AgitPOV/AgitPOV_WiFi/Stuff/AgitPOV_WiFi_1.jpg

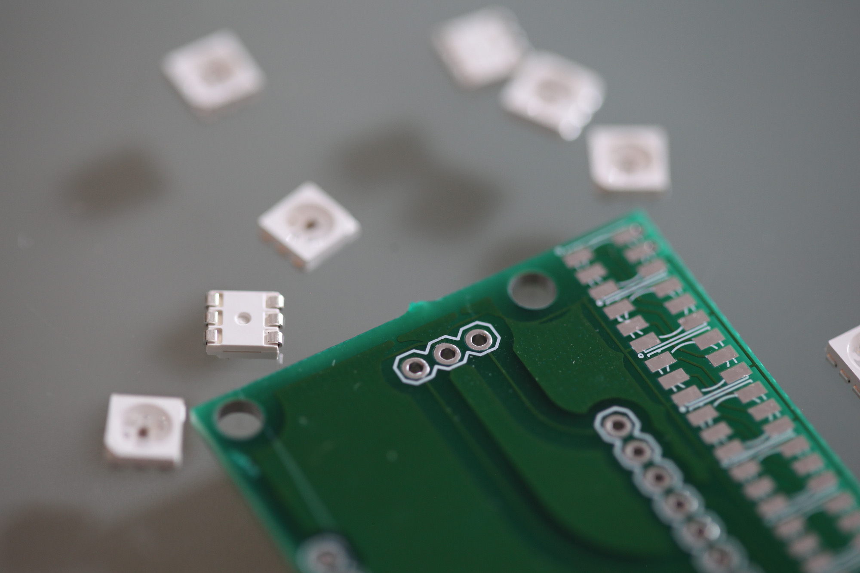
Stuff/AgitPOV_WiFi_1.jpg
