AgitPOV/AgitPOV_WiFi/Stuff/AgitPOV_WiFi_2.jpg

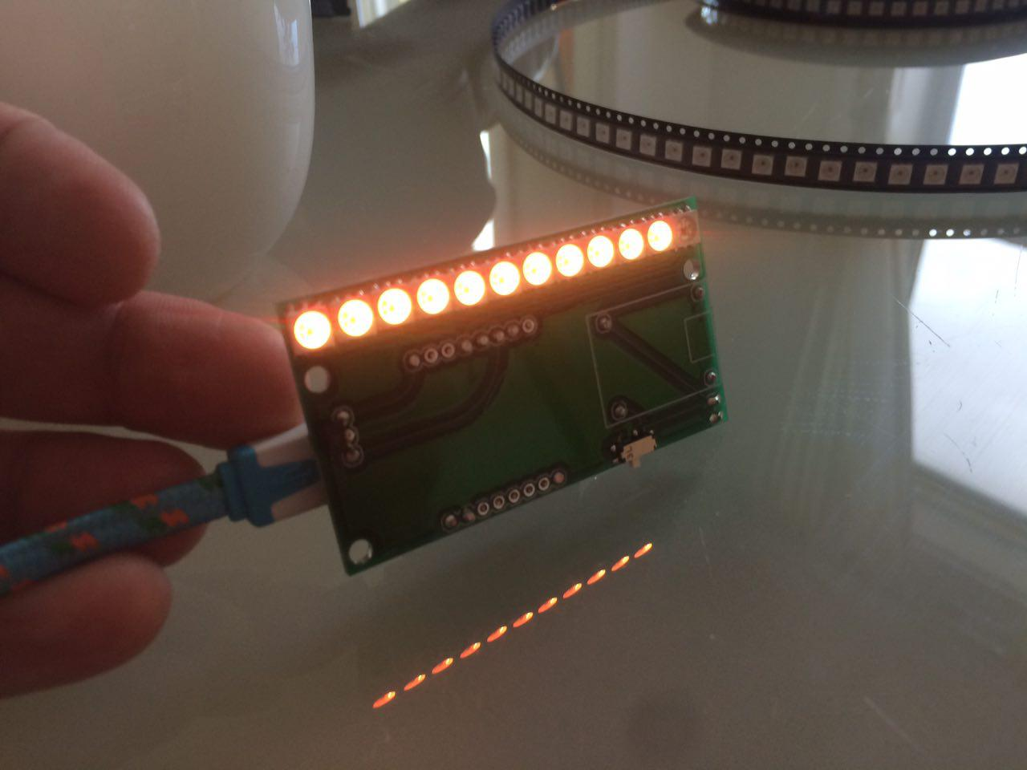
Stuff/AgitPOV_WiFi_2.jpg
