AgitPOV/AgitPOV_WiFi/README.md

#  AgitPOV Wifi: 24-RGB LED dual sided POV with Wifi (ESP8266)

 (c) 2011-2017
 Contributors over the years for this version

* Thomas Ouellet Fredericks - Debuging, Accelerometer and LED engine and animation code
* Alexandre Castonguay
* Andre Girard andre@andre-girard.com
* Alan Kwok
* Sofian Audry
* Mariangela Aponte Nuñez
* Jean-Pascal Bellemare
* Daniel Felipe Valencia dfvalen0223@gmail.com
* Alex Keeling

[FR] Cette version utilise une puce ESP8266 qui permet de programmer un mot à partir de n'importe quelle connexion WiFi.
Les DELs RVB seront pré-assemblées pour que les ateliers se concentrent sur la sélection des mots que nous aimerions voir
dans nos roues de vélo, et de passer plus de temps à parcourir la ville. Les batteries sont rechargeables donc les POVs 
seront utiles plus longtemps et finalement, nous travaillons avec un designer industriel qui va développer un boitier résistant, 
imperméable et facile à placer et retirer des rayons. Tous les fichiers sont ici et nous produisons les plaquettes et les 
boitiers sous peu!

[ES] Este versión usa a un ESP8266 que permite de programar una palabra desde un dispositivo WiFi. Usamos DELs 
premontados porque los talleres se vuelven en intercambios sobre las palabras que quérémos ver en nuestra ruedas 
de bicicletas y también de pasar más tiempo juntas en una rodada. Baterías están rescargable y trabajamos con un 
diseñador sobre cajas, durables, resistente al agua y fácil de poner y quitar de los rayos de nuestras bicis. Los 
archivos están aquí y vamos a producir los plaquetas y cajas de pronto!

[EN] This version uses an ESP8266 board that let's you program your word from a WiFi device. Surface mount RGB LEDs 
(APA102C) are already soldered so we spend more time discussing what words to put on our bikes and get more time out 
in the city together. The batteries are rechargeable so people can keep using their POVs longer. Finally, we are working 
with an industrial designer so we can get sturdy, water resistant cases that are easy to put in and out of your spokes. 
All the basic files are here and we'll let you know when the boards and cases are ready!
