AgitPOV/AgitPOV_WiFi/Board/eagleUp/eagleUp_AgitPOV_WiFi_board_bottom.png

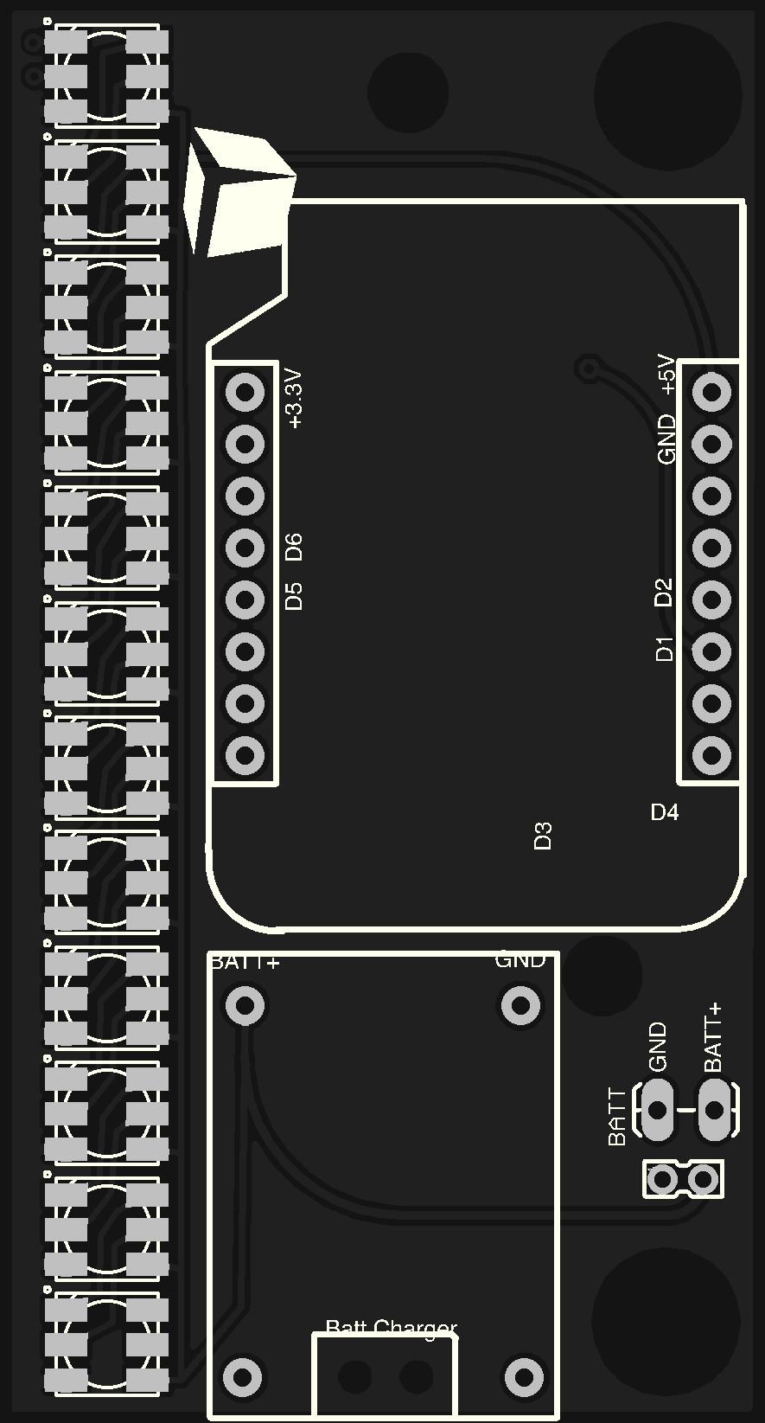
Board/eagleUp/eagleUp_AgitPOV_WiFi_board_bottom.png
