AgitPOV/AgitPOV_WiFi/Board/eagleUp/eagleUp_AgitPOV_WiFi_board_top.png

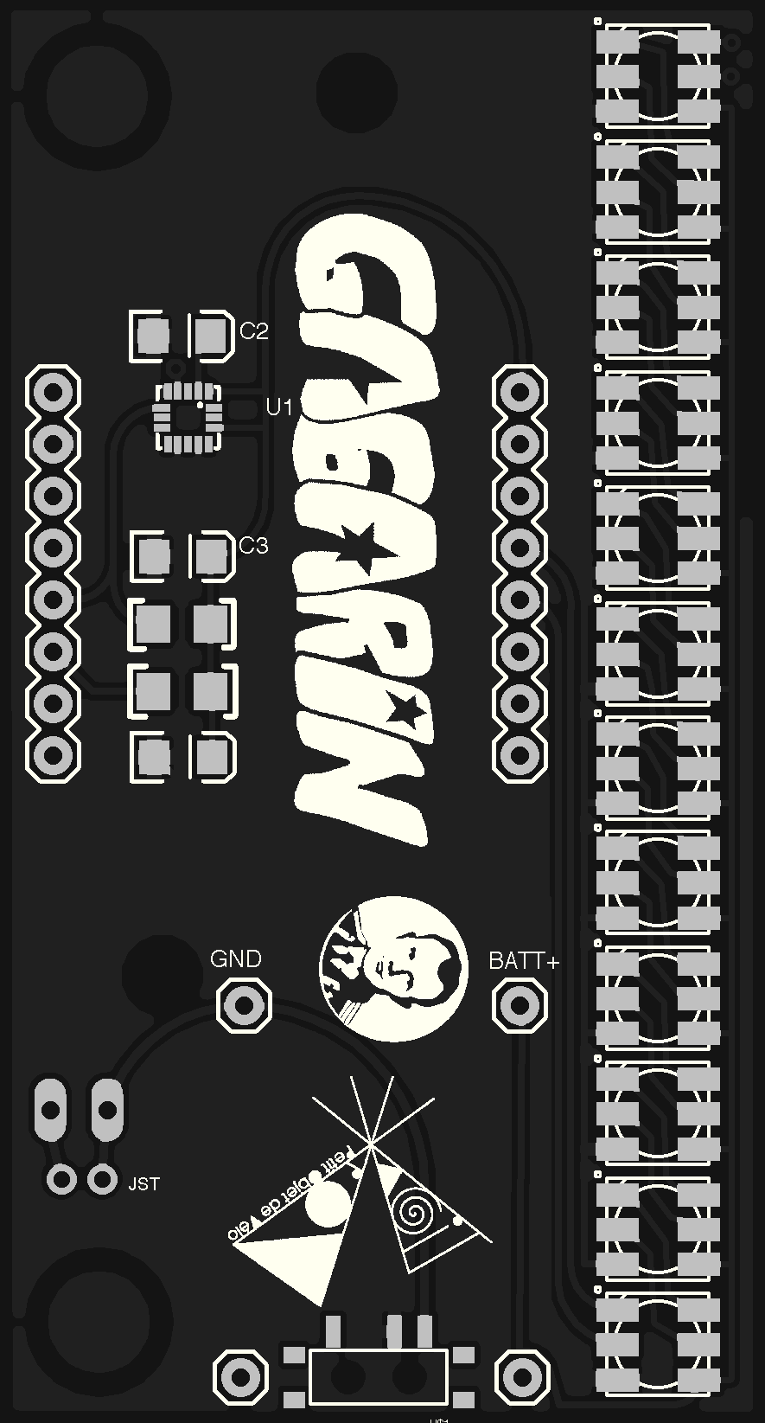
Board/eagleUp/eagleUp_AgitPOV_WiFi_board_top.png
