AgitPOV/AgitPOV_WiFi/Stuff/illustrated-arabic-words-mahmoud-tammam-1.jpg

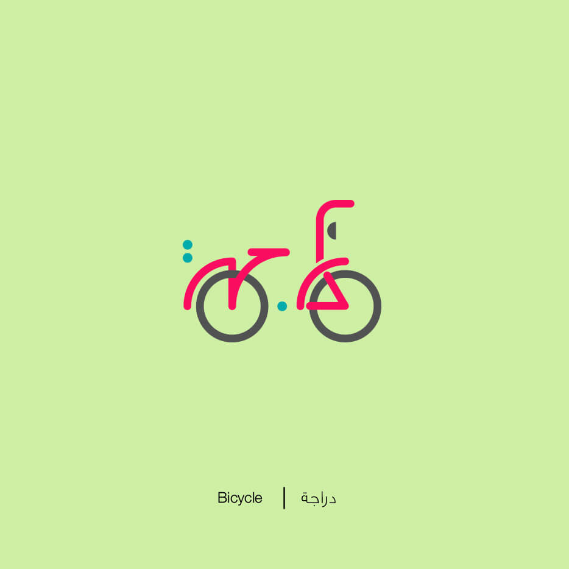
Stuff/illustrated-arabic-words-mahmoud-tammam-1.jpg
