AgitPOV/AgitPOV_WiFi/Stuff/MMA8452Q/Calculator 2017-03-14 16_54_31.png

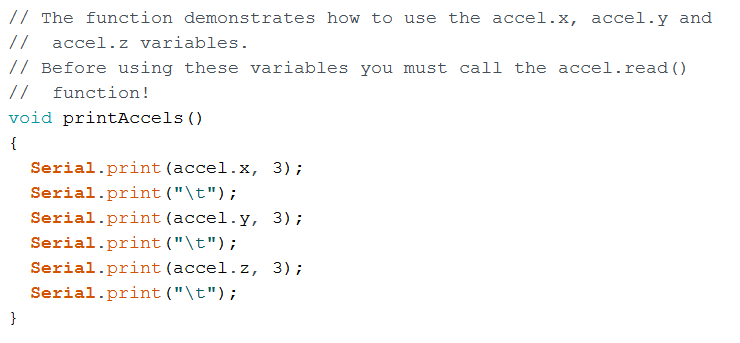
Stuff/MMA8452Q/Calculator 2017-03-14 16_54_31.png
