AgitPOV/AgitPOV_WiFi/Stuff/MMA8452Q/MMA8452Q 3-axis, 12-bit_8-bit digital accelerometer - MMA8452Q.pdf 2017-03-14 16_49_50.png

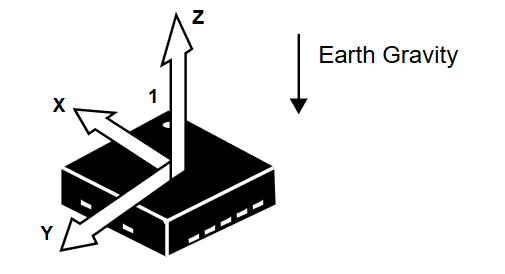
Stuff/MMA8452Q/MMA8452Q 3-axis, 12-bit_8-bit digital accelerometer - MMA8452Q.pdf 2017-03-14 16_49_50.png
