AgitPOV/AgitPOV_WiFi/Stuff/MMA8452Q/SparkFun_MMA8452Q_Basic _ Arduino 1.6.12 2017-03-14 16_55_10.png

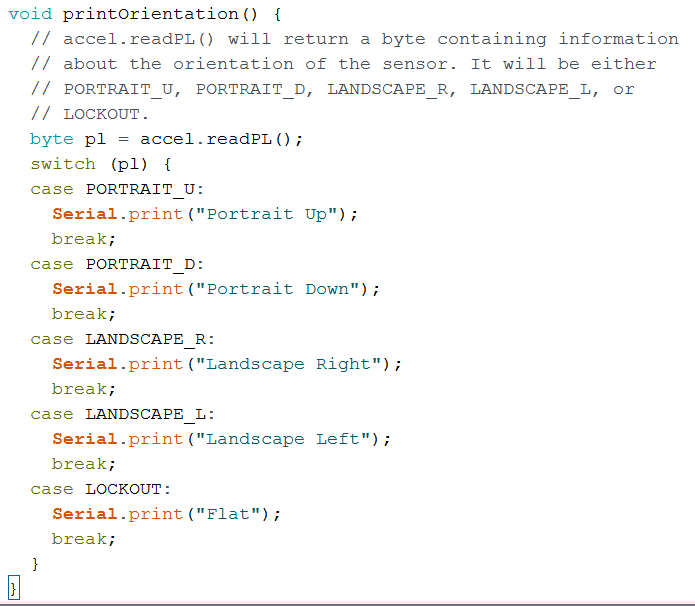
Stuff/MMA8452Q/SparkFun_MMA8452Q_Basic _ Arduino 1.6.12 2017-03-14 16_55_10.png
