AgitPOV/AgitPOV_WiFi/Stuff/AC_1000_BOM_AgitPOV_WiFi.xls

Sheet: PCB SPECS(please fill in and se
 |  | PCB Specification |  |  |  |  |  |  |  | Test
Quantity | PCB Size(mm) |  | Board Material | Layers | Thickness | Copper | Surface Finish | Solder Mask Color | Silkscreen Color | Test | Test
 | X | Y |  |  | (mm) | (µm) |  |  |  | Method | Qty
 |  |  | FR-4 | 2 | 1.2 | 35 | HASL (Hot Air Surface Leveling) | Red | White | Flying Probe | 100.00%

Sheet: BOM(please fill in)
 | BOM quantity (Required) |  | PCB/Project Name
 | Part Identification |  |  |  |  |  |  |  | Customer Information |  | Quantity
# | Part ID / Reference (Required) | Manufacturer | Part / Order Number (Required) | Description | Value (Required) | Package (Required) | THT (y/n) | Pins / Pads | Source/Link/ Datasheet/Note | Source / Target Price | Quantity per BOM (Required)

Sheet: Reference
 | BOM quantity | 10 |  | PCB/Project Name | AgitPOV_WiFi
 | Part Identification |  |  |  |  |  |  |  | Customer Information |  | Quantity
# | Part ID / Reference | Manufacturer | Part / Order Number | Description | Value | Package | THT (y/n) | Pins / Pads | Source/Link/ Datasheet/Note | Source / Target Price | Quantity per BOM | Estimation
 |  | Aliexpress |  | Microcontrôleurs WiFI | Wemos D1 mini | Microcontrôleur Wemos | y | 16 | http://www.aliexpress.com/snapshot/7403403143.html?orderId=73408283519218 | 6 | 1 | 3.83
 |  | Aliexpress |  | Chargeur batterie | 3.7v Charger Dealextreme | IC | y | 4 | http://www.ebay.com/itm/10pcs-Micro-USB-5V-1A-Lithium-Battery-Charging-Board-Charger-Module/370865460416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 | 0.8 | 1 | 0.8
 |  | Aliexpress |  | Batterie (LiPO 600 mAH) | 600 mAh | BATT |  |  |  | 5 | 1 | 4
 |  | Digikey | CW181-ND | on-off |  |  | n | 7 | CW181-ND | 0.9 | 1 | 0.9
 |  | McMaster-Carr | 97763A104 (https://www.mcmaster.com/nav/enter.asp?partnum=97763A104) | 18-8 Stainless Steel Hex Drive Rounded Head Screws, Black-Oxide, 4-40 Thread Size, 1/2" Long, Packs of 100 | Boulons |  |  |  |  | 0.3 | 4 | 0.3
 |  | McMaster-Carr | 93365A122 (https://www.mcmaster.com/nav/enter.asp?partnum=93365A122) | Heat-Set Inserts for Plastics, 4-40 Thread Size, 0.219" Installed Length, Packs of 100 | Inserts |  |  |  |  | 0.69 | 4 | 0.69
 |  | Digikey | 732-5350-ND | Battery connector |  |  |  |  |  | 0.1 | 1 | 0.1
 |  | Artistes Anonymes |  | Assemblage des composantes |  |  |  |  |  |  |  | 5
 |  |  |  |  |  |  |  |  |  |  | Total | 15.62
 |  | X-rech technologies
 |  | Item # | Description |  | Coût
 |  | 1 | WEMOS |  | 3.83
 |  | 2 | Charger |  | 0.8
 |  | 3 | BATT |  | 4
 |  | 4 | Button |  | 0.9
 |  | 5 | Boulons |  | 0.3
 |  | 6 | Insert |  | 0.69
 |  | 7 | Connecteur |  | 0.1
 |  |  |  | Sous-total par boitier | 10.62 |  |  |  | 1 | Assemblage |  | 4 * 1000 unités | 4000
 |  |  |  |  | * 1000 unités | 10620 |  |  | 2 | Frais d'expédition boitiers | 838 USD |  | 1089.4
 |  |  |  |  | Total | 10620 |  |  |  |  |  | Total | 5089.4
 |  |  |  |  | TPS (5%) : | 531 |  |  |  |  |  | TPS (5%) : | 254.47
 |  |  |  |  | TVQ (9,975%) : | 1059.35 |  |  |  |  |  | TVQ (9,975%) : | 507.67
 |  |  |  |  | Total | 12210.34 |  |  |  |  |  | Total | 5851.54

Sheet: Shipping Details
Consignee | Alexandre Castonguay / Artistes anonymes
Address 1 | 2002 Laurier
Address 2
City | Montréal
Postcode | H2H 1B7
State | Québec
Country | Canada
Telephone Number | 1.514.941.8492
Email Address | acastonguay@artengine.ca

Sheet: boitier
Compagnie | Adresse | Contact |  | Moule | Matériel | Prix (USD) | Coût par untié produite | Quantité | Coût de production total | Coût unitaire
Web: www.xmrex-tech.com | Unit 710,Bldg. 2, Yulong Intl. Bldg., No. 989, Anling Road, Huli High-tech Park, Xiamen, China | "evelyn.su" <evelyn.su@xmrex-tech.com> |  | Plastic injection | ABS | 4477 | 1.39 | 1000 | 5867 | 5.867
 |  | Sébastien Dallaire
 |  |  | Option 1 | Silicon mold | proto ABS + laque | 400 | 30 | 100 | 3400 | 34
 |  |  | Option 2 | Plastic injection mold | ABS | 4000 | 3 | 100 | 4300 | 43
 |  |  |  |  |  |  |  | 500 | 5500 | 11
 |  |  |  |  |  |  |  | 1000 | 7000 | 7

Sheet: McMasterCarr
McMaster-Carr
 | Boulons et inserts
 |  | 209.16 | USD | Boulons | 270.86 | 0.30
 |  | 419.4 | USD | Inserts | 543.12 | 0.60
 |  |  |  | Sous-total | 813.99 | 0.90
 |  | 64 | USD | Shipping | 82.88 | 0.09
 |  |  |  | Total |  | 1.00 | Coût unitaire

Sheet: AliExpress
Wemos | Order number | Supplier | Description | Quantity | Coût USD | Coût CAN 1,3 | Shipping | Douanes | Total | Coût unitaire |  | Confirmation shipping
 | 84819321929218 | Mega Semiconductor CO., Ltd. (https://www.aliexpress.com/store/808897) | D1 mini | 200 | 530 | 689 | 50 | 60 | 799 | 4.00 | DHL 4269322304 |  | 4269322304 | DHL | 2017-07-31
 | 84887303969218 | Mega Semiconductor CO., Ltd. (https://www.aliexpress.com/store/808897) | D1 mini | 200 | 530 | 689 | 50 | 60 | 799 | 4.00 | DHL 4269322304
 | 84848898169218 | Vicky Gao | D1 mini | 200 | 526.05 | 683.87 | 0 | 60 | 743.87 | 3.72 | AliExpress Standard Shipping | LP00074081846034
 | 84957310379218 | Vicky Gao | D1 mini | 200 | 526.05 | 683.87 | 0 | 60 | 743.87 | 3.72 | AliExpress Standard Shipping | LP00074081643013
 | 84849494039218 | Vicky Gao | D1 mini | 100 | 263.89 | 343.06 | 0 | 30 | 373.06 | 3.73 | AliExpress Standard Shipping | LP00074081696744
 |  |  |  | 900 |  |  |  |  |  | 3.83
Batteries
 | 84888906489218 | 50pcs/lot 3.7V 600mAh 25C li-po lipo batterie akku Battery for Rc R/c helicopter MOdel+register free shipping (https://www.aliexpress.com/snapshot/0.html?orderId=84888906489218&productId=541398568) | Lipo Battery 3,7V | 100 | 190 | 247.00 | 0 | 50 | 297 | 2.97
 | 84889024309218 | 50pcs/lot 3.7V 600mAh 25C li-po lipo batterie akku Battery for Rc R/c helicopter MOdel+register free shipping (https://www.aliexpress.com/snapshot/0.html?orderId=84888906489218&productId=541398568) | Lipo Battery 3,7V | 100 | 190 | 247.00 | 0 | 50 | 297 | 2.97
 | 84958555499218 | 50pcs/lot 3.7V 600mAh 25C li-po lipo batterie akku Battery for Rc R/c helicopter MOdel+register free shipping (https://www.aliexpress.com/snapshot/0.html?orderId=84888906489218&productId=541398568) | Lipo Battery 3,7V | 100 | 190 | 247.00 | 0 | 50 | 297 | 2.97
 | 84820969079218 | 50pcs/lot 3.7V 600mAh 25C li-po lipo batterie akku Battery for Rc R/c helicopter MOdel+register free shipping (https://www.aliexpress.com/snapshot/0.html?orderId=84888906489218&productId=541398568) | Lipo Battery 3,7V | 150 | 280 | 364.00 | 0 | 70 | 434 | 2.89
 | 84850734359218 | 50pcs/lot 3.7V 600mAh 25C li-po lipo batterie akku Battery for Rc R/c helicopter MOdel+register free shipping (https://www.aliexpress.com/snapshot/0.html?orderId=84888906489218&productId=541398568) | Lipo Battery 3,7V | 150 | 280 | 364.00 | 0 | 70 | 434 | 2.89
 | 84821400709218 | 50pcs/lot 3.7V 600mAh 25C li-po lipo batterie akku Battery for Rc R/c helicopter MOdel+register free shipping (https://www.aliexpress.com/snapshot/0.html?orderId=84888906489218&productId=541398568) | Lipo Battery 3,7V | 150 | 280 | 364.00 | 0 | 70 | 434 | 2.89
 | 85045065209218 |  | Lipo Battery 3,7V | 100 | 257.18 | 334.33 | 0 | 50 | 384.33 | 3.84 |  |  |  | shipped
 | 85117917909218 |  | Lipo Battery 3,7V | 100 | 201.98 | 262.57 | 0 | 50 | 312.57 | 3.13 |  |  |  | shipped
 |  |  |  | 950
Chargeurs USB
 | Ebay | sweetsale07 (http://www.ebay.com/usr/sweetsale07?_trksid=p2057872.m2749.l2754) | 10Pcs 5V Micro USB 1A TP4056 Lithium Battery Charging Board Power Charger Module (http://www.ebay.com/itm/10Pcs-5V-Micro-USB-1A-TP4056-Lithium-Battery-Charging-Board-Power-Charger-Module/192061188983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) | 200 | 54.4 | 70.72 | 0 | 10 | 80.72 | 0.40 | Estimated delivery Fri, Jul 14 - Fri, Aug 18 |  |  |  | Tracking number: Tracking number4006318007240346
 | Ebay | sweetsale07 (http://www.ebay.com/usr/sweetsale07?_trksid=p2057872.m2749.l2754) | 10Pcs 5V Micro USB 1A TP4056 Lithium Battery Charging Board Power Charger Module (http://www.ebay.com/itm/10Pcs-5V-Micro-USB-1A-TP4056-Lithium-Battery-Charging-Board-Power-Charger-Module/192061188983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) | 100 | 27.2 | 35.36 | 0 | 10 | 45.36 | 0.45 | Estimated delivery Fri, Jul 14 - Fri, Aug 18 |  |  |  | Tracking number: Tracking number4006318007240353
 | Ebay | rcga6821 (http://www.ebay.com/usr/rcga6821?_trksid=p2057872.m2749.l2754) | 10pcs TP4056 Micro USB Charger Module 5V 1A 18650 Lithium Battery Charging Board (http://www.ebay.com/itm/10pcs-TP4056-Micro-USB-Charger-Module-5V-1A-18650-Lithium-Battery-Charging-Board/272570928685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) | 200 | 51.8 | 67.34 | 0 | 10 | 77.34 | 0.39 | Estimated delivery Thu, Jul 27 - Fri, Sep 01 |  |  |  | Tracking number: Tracking numberEA311864867CN
 | Ebay | rcga6821 (http://www.ebay.com/usr/rcga6821?_trksid=p2057872.m2749.l2754) | 10pcs TP4056 Micro USB Charger Module 5V 1A 18650 Lithium Battery Charging Board (http://www.ebay.com/itm/10pcs-TP4056-Micro-USB-Charger-Module-5V-1A-18650-Lithium-Battery-Charging-Board/272570928685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) | 200 | 51.8 | 67.34 | 0 | 10 | 77.34 | 0.39 | Estimated delivery Thu, Jul 27 - Fri, Sep 01 |  |  |  | Tracking number: Tracking numberEA311864867CN
 |  |  |  | 700
 |  | 84888906489218
