AgitPOV/AgitPOV_WiFi/Stuff/BOM_AgitPOV_WiFi.xls

Sheet: PCB SPECS(please fill in and se
 |  | PCB Specification |  |  |  |  |  |  |  | Test
Quantity | PCB Size(mm) |  | Board Material | Layers | Thickness | Copper | Surface Finish | Solder Mask Color | Silkscreen Color | Test | Test
 | X | Y |  |  | (mm) | (µm) |  |  |  | Method | Qty
 |  |  | FR-4 | 2 | 1.2 | 35 | HASL (Hot Air Surface Leveling) | Red | White | Flying Probe | 100.00%

Sheet: BOM(please fill in)
 | BOM quantity (Required) |  | PCB/Project Name
 | Part Identification |  |  |  |  |  |  |  | Customer Information |  | Quantity
# | Part ID / Reference (Required) | Manufacturer | Part / Order Number (Required) | Description | Value (Required) | Package (Required) | THT (y/n) | Pins / Pads | Source/Link/ Datasheet/Note | Source / Target Price | Quantity per BOM (Required)

Sheet: Reference
 | BOM quantity | 10 |  | PCB/Project Name | AgitPOV_WiFi
 | Part Identification |  |  |  |  |  |  |  | Customer Information |  | Quantity
# | Part ID / Reference | Manufacturer | Part / Order Number | Description | Value | Package | THT (y/n) | Pins / Pads | Source/Link/ Datasheet/Note | Source / Target Price | Quantity per BOM |  |  | Actuels |  | Actuels | Unitaire
1 | C1, C2 | Yaego | Need to source | CAP CER 0.1UF 50V X7R 1206 | 1uF | 1206 | n | 2 | 311-1179-1-ND | 0.15 | 2 | 0.3
2 | C3 | Taiyo Yuden (http://www.digikey.com/en/supplier-centers/t/taiyo-yuden) | Need to source | CAP CER 4.7UF 50V X7R 1206 | 4.7uF | 1206 | n | 2 | 587-2994-1-ND (http://www.digikey.com/product-detail/en/taiyo-yuden/UMK316AB7475KL-T/587-2994-1-ND/2714187) | 0.15 | 1 | 0.15
3 | R2,R3 | Stackpole Electronics Inc. (http://www.digikey.ca/en/supplier-centers/s/stackpole-electronics) | Need to source | RES SMD 4.7K OHM 5% 1/4W 1206 | 4.7k | 1206 | n | 2 | RMCF1206JT4K70CT-ND | 0.20 | 2 | 0.4
4 | ACCEL | NXP USA Inc. (http://www.digikey.ca/en/supplier-centers/n/nxp-semiconductors) | Need to source | ACCELEROMETER 2-8G I2C 16QFN |  | QFN | n | 16 | MMA8452QR1CT-ND | 1.6963 | 1 | 1.6963
5 | LED1-LED24 | Shenzhen LED Color Opto Electronic Co., LTD | Will be sent from manufacturer | APA102C or Sk9822 (same form factor) | LED SMT | 5050 | n | 6 | See .pdf | 4.00 | 1 | 4
6 | WEMOS |  |  | Microcontrôleurs WiFI | Wemos D1 mini | Microcontrôleur Wemos | y | 16 | http://www.aliexpress.com/snapshot/7403403143.html?orderId=73408283519218 | 6 | 1 | 6 |  |  |  |  | 6
7 | Charger |  |  | Chargeur batterie | 3.7v Charger Dealextreme | IC | y | 4 | http://www.ebay.com/itm/10pcs-Micro-USB-5V-1A-Lithium-Battery-Charging-Board-Charger-Module/370865460416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 | 0.8 | 1 | 0.8 |  |  |  |  | 0.8
8 | BATT |  |  | Batterie (LiPO 600 mAH) | 600 mAh | BATT |  |  |  | 5 | 1 | 5 |  |  |  |  | 5
 |  |  |  |  |  |  |  |  |  | 5 | 1 | 5
9 | BOARD | Smart-Prototyping |  | 2 sided, 48 mm x 68 mm |  |  |  |  |  | 6.82212 | 1 | 6.82212
10 | Button |  |  | on-off |  |  | n | 7 | CW181-ND | 0.9 | 1 |  |  | 816.94 | Boutons | 816.94 | 0.82
11 |  | McMaster-Carr | 97763A104 (https://www.mcmaster.com/nav/enter.asp?partnum=97763A104) | 18-8 Stainless Steel Hex Drive Rounded Head Screws, Black-Oxide, 4-40 Thread Size, 1/2" Long, Packs of 100 | Boulons |  |  |  |  | 0.3 | 4 |  |  | 40.84 | Taxes | 40.84 | 0.04
12 |  | McMaster-Carr | 93365A122 (https://www.mcmaster.com/nav/enter.asp?partnum=93365A122) | Heat-Set Inserts for Plastics, 4-40 Thread Size, 0.219" Installed Length, Packs of 100 | Inserts |  |  |  |  | 0.6 | 4 |  |  |  | Boulons et inserts |  | 1
 |  |  |  |  |  |  |  |  | Shipping | 0.09 | 1
 |  |  |  |  |  |  |  |  |  |  |  | 0.9
 |  |  |  |  |  |  |  |  |  |  |  | 31.07
 |  |  |  |  |  |  |  |  |  |  |  | 4 $ | Shipping / Duties
 |  |  |  | 209.16 | USD | Boulons | 270.86 | 0.30 |  |  |  | 35.01 | Total
 |  |  |  | 419.4 | USD | Inserts | 543.12 | 0.60
 |  |  |  |  |  | Sous-total | 813.99 | 0.90
 |  |  |  | 64 | USD | Shipping | 82.88 | 0.09
 |  |  |  |  |  | Total |  | 1.00

Sheet: Shipping Details
Consignee | Alexandre Castonguay / Artistes anonymes
Address 1 | 2002 Laurier
Address 2
City | Montréal
Postcode | H2H 1B7
State | Québec
Country | Canada
Telephone Number | 1.514.941.8492
Email Address | acastonguay@artengine.ca

Sheet: boitier
Compagnie | Adresse | Contact |  | Moule | Matériel | Prix (USD) | Coût par untié produite | Quantité | Coût de production total | Coût unitaire
Web: www.xmrex-tech.com | Unit 710,Bldg. 2, Yulong Intl. Bldg., No. 989, Anling Road, Huli High-tech Park, Xiamen, China | "evelyn.su" <evelyn.su@xmrex-tech.com> |  | Plastic injection | ABS | 4477 | 1.39 | 1000 | 5867 | 5.867
 |  | Sébastien Dallaire
 |  |  | Option 1 | Silicon mold | proto ABS + laque | 400 | 30 | 100 | 3400 | 34
 |  |  | Option 2 | Plastic injection mold | ABS | 4000 | 3 | 100 | 4300 | 43
 |  |  |  |  |  |  |  | 500 | 5500 | 11
 |  |  |  |  |  |  |  | 1000 | 7000 | 7

Sheet: Feuil1
McMaster-Carr
 | Boulons et inserts
 |  | 209.16 | USD | Boulons | 270.86 | 0.30
 |  | 419.4 | USD | Inserts | 543.12 | 0.60
 |  |  |  | Sous-total | 813.99 | 0.90
 |  | 64 | USD | Shipping | 82.88 | 0.09
 |  |  |  | Total |  | 1.00
