AgitPOV/AgitPOV_WiFi/Board/BOM_AgitPOV_WiFi_smart_prototyping.xls

Sheet: PCB SPECS(please fill in and se
 |  | PCB Specification |  |  |  |  |  |  |  | Test
Quantity | PCB Size(mm) |  | Board Material | Layers | Thickness | Copper | Surface Finish | Solder Mask Color | Silkscreen Color | Test | Test
 | X | Y |  |  | (mm) | (µm) |  |  |  | Method | Qty
 |  |  | FR-4 | 2 | 1.2 | 35 | HASL (Hot Air Surface Leveling) | Red | White | Flying Probe | 100.00%

Sheet: BOM(please fill in)
 | BOM quantity (Required) |  | PCB/Project Name
 | Part Identification |  |  |  |  |  |  |  | Customer Information |  | Quantity
# | Part ID / Reference (Required) | Manufacturer | Part / Order Number (Required) | Description | Value (Required) | Package (Required) | THT (y/n) | Pins / Pads | Source/Link/ Datasheet/Note | Source / Target Price | Quantity per BOM (Required)

Sheet: Reference
 | BOM quantity | 10 |  | PCB/Project Name | AgitPOV_WiFi
 | Part Identification |  |  |  |  |  |  |  | Customer Information |  | Quantity
# | Part ID / Reference | Manufacturer | Part / Order Number | Description | Value | Package | THT (y/n) | Pins / Pads | Source/Link/ Datasheet/Note | Source / Target Price | Quantity per BOM
1 | C1, C2 | Yaego | Need to source | CAP CER 0.1UF 50V X7R 1206 | 1uF | 1206 | n | 2 | 311-1179-1-ND | 0.15 | 2
2 | C3 | Taiyo Yuden (http://www.digikey.com/en/supplier-centers/t/taiyo-yuden) | Need to source | CAP CER 4.7UF 50V X7R 1206 | 4.7uF | 1206 | n | 2 | 587-2994-1-ND (http://www.digikey.com/product-detail/en/taiyo-yuden/UMK316AB7475KL-T/587-2994-1-ND/2714187) | 0.15 | 1
3 | R2,R3 | Stackpole Electronics Inc. (http://www.digikey.ca/en/supplier-centers/s/stackpole-electronics) | Need to source | RES SMD 4.7K OHM 5% 1/4W 1206 | 4.7k | 1206 | n | 2 | RMCF1206JT4K70CT-ND | 0.20 | 2
4 | ACCEL | NXP USA Inc. (http://www.digikey.ca/en/supplier-centers/n/nxp-semiconductors) | Need to source | ACCELEROMETER 2-8G I2C 16QFN |  | QFN | n | 16 | MMA8452QR1CT-ND | 1.6963 | 1
5 | LED1-LED24 | http://www.szledcolor.com/productshow.asp?id=958&sid=199 | Need to source | Sk9822 (same form factor) | LED SMT | 5050 | n | 6 | See .pdf | 0.20 | 24
5 | LED1-LED24 | http://www.szledcolor.com/productshow.asp?id=878&sid=199 | Need to source | APA102C | LED SMT | 5050 | n | 6 | See .pdf | 0.2 | 24
 | For the LEDs :
 | Shenzhen LED Color Opto Electronic Co., LTD
 | Phone:+86-755 -2735 0605 Telephone:+86-136 7021 6169 Email: ivy@szlcoe.com
 | Add:3/F,2/B,Henghui Technology Park,No.63,Yuxing Road,Yulv,Gongming Town,Shenzhen,China

Sheet: Shipping Details
Consignee | Alexandre Castonguay / Artistes anonymes
Address 1 | 2002 Laurier
Address 2
City | Montréal
Postcode | H2H 1B7
State | Québec
Country | Canada
Telephone Number | 1.514.941.8492
Email Address | acastonguay@artengine.ca
