AgitPOV/AgitPOV_WiFi/Stuff/tests_spiffs_/record002.png

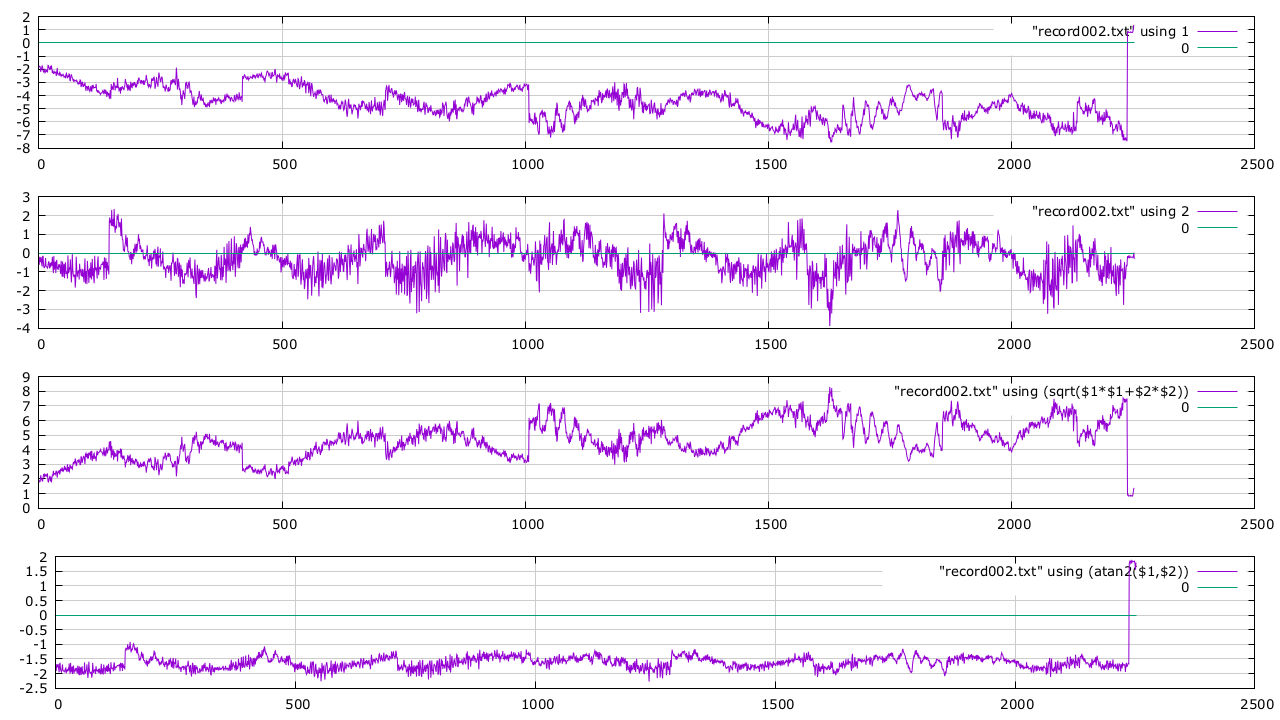
Stuff/tests_spiffs_/record002.png
