AgitPOV/AgitPOV_WiFi/Stuff/tests_spiffs_/test.png

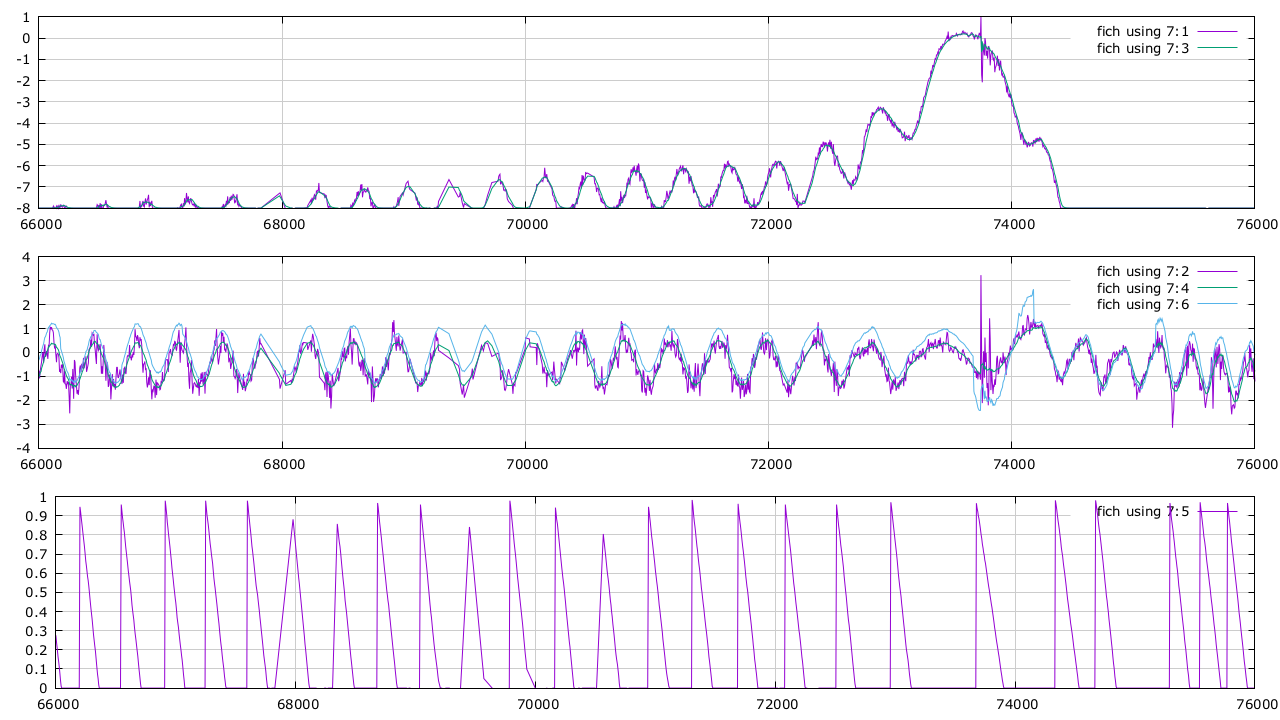
Stuff/tests_spiffs_/test.png
