AgitPOV/AgitPOV_WiFi/Stuff/tests_spiffs_/valentina.png

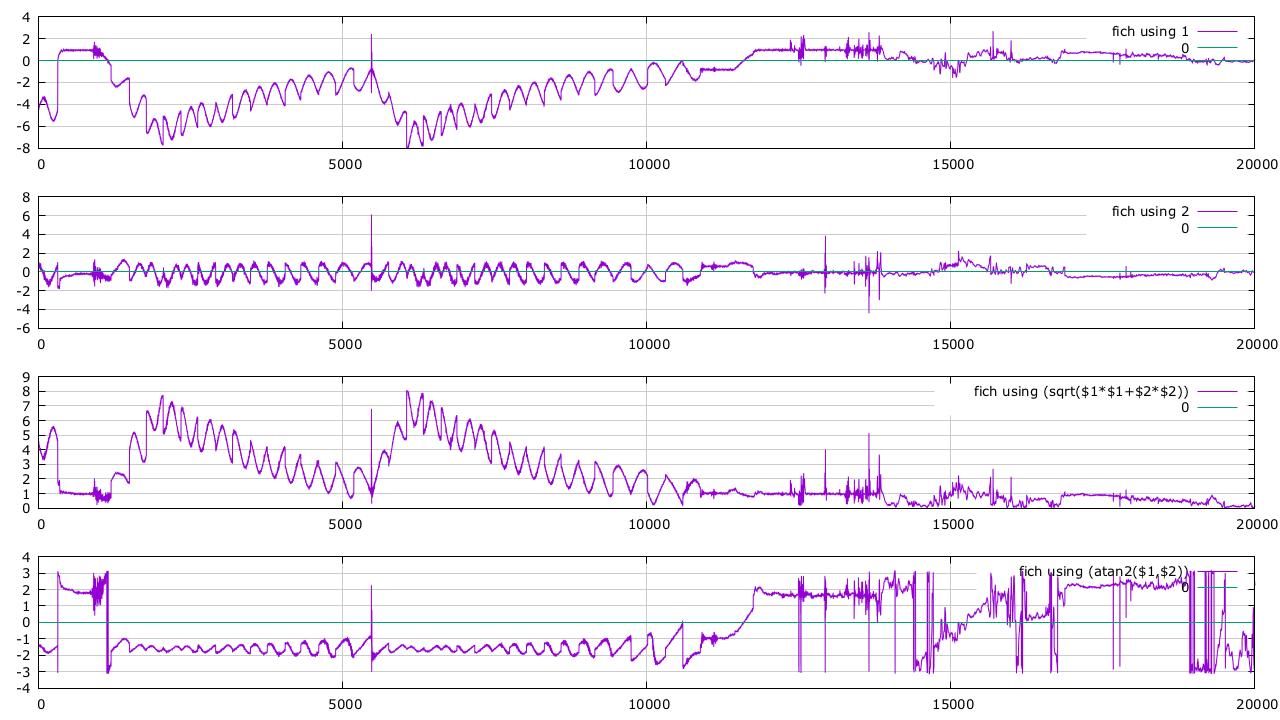
Stuff/tests_spiffs_/valentina.png
