AgitPOV/AgitPOV_WiFi/Board/AgitPOV_WiFi.brd

## EAGLE design Board/AgitPOV_WiFi.brd (2019-07-22)

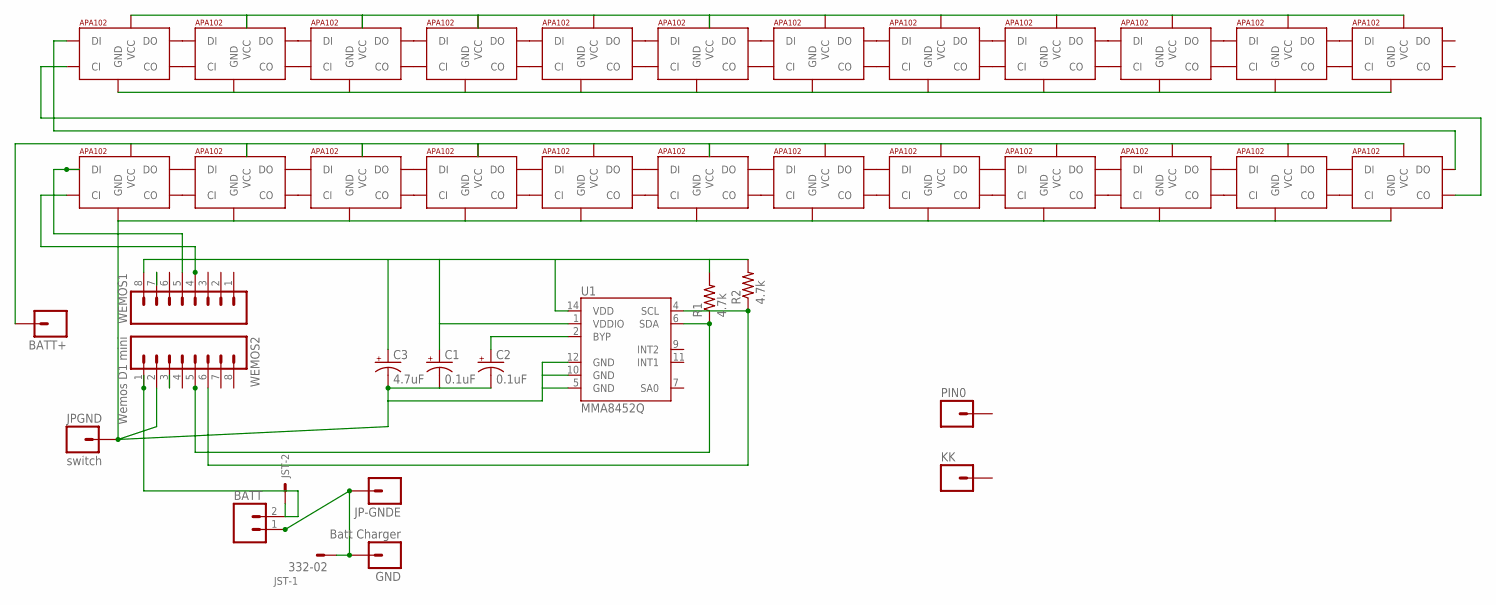
[picture p13: schematic AgitPOV_WiFi.sch]

Parts:
BATT: M02LOCK_LONGPADS; 1X02_LOCK_LONGPADS
BATT+: M01PTH; 1X01
C1, C2: 0.1uF; EIA3216
C3: 4.7uF; EIA3216
DEL1, DEL2, DEL3, DEL4, DEL5, DEL6, DEL7, DEL8, DEL9, DEL10, DEL11, DEL12, DEL13, DEL15, DEL16, DEL17, DEL18, DEL19, DEL20, DEL21, DEL22, DEL23, DEL24: APA1025050; APA102_5050
FFFFF: APA1025050; APA102_5050
GND: Batt Charger; 1X01
JP-GNDE: M01PTH; 1X01
JPGND: switch; 1X01
JST: 332-02
KK: M01PTH; 1X01
PIN0: M01PTH; 1X01
R1, R2: 4.7k; 1206
U1: MMA8452Q; QFN-16_0.5MM
WEMOS1: M08; 1X08_ROUND
WEMOS2: Wemos D1 mini; 1X08_ROUND

Connections:
5V: BATT.2, BATT+.1, DEL1.1 (VCC), DEL2.1 (VCC), DEL3.1 (VCC), DEL4.1 (VCC), DEL5.1 (VCC), DEL6.1 (VCC), DEL7.1 (VCC), DEL8.1 (VCC), DEL9.1 (VCC), DEL10.1 (VCC), DEL11.1 (VCC), DEL12.1 (VCC), DEL13.1 (VCC), DEL15.1 (VCC), DEL16.1 (VCC), DEL17.1 (VCC), DEL18.1 (VCC), DEL19.1 (VCC), DEL20.1 (VCC), DEL21.1 (VCC), DEL22.1 (VCC), DEL23.1 (VCC), DEL24.1 (VCC), FFFFF.1 (VCC), JST.2, WEMOS2.1
+3.3V: C1.A (+), C3.A (+), R1.2, R2.2, U1.1 (VDDIO), U1.14 (VDD), WEMOS1.8
BYP: C2.A (+), U1.2 (BYP)
ENTREEGND: BATT.1, GND.1, JP-GNDE.1, JST.1
GND: C1.C (-), C2.C (-), C3.C (-), DEL1.6 (GND), DEL2.6 (GND), DEL3.6 (GND), DEL4.6 (GND), DEL5.6 (GND), DEL6.6 (GND), DEL7.6 (GND), DEL8.6 (GND), DEL9.6 (GND), DEL10.6 (GND), DEL11.6 (GND), DEL12.6 (GND), DEL13.6 (GND), DEL15.6 (GND), DEL16.6 (GND), DEL17.6 (GND), DEL18.6 (GND), DEL19.6 (GND), DEL20.6 (GND), DEL21.6 (GND), DEL22.6 (GND), DEL23.6 (GND), DEL24.6 (GND), FFFFF.6 (GND), JPGND.1, U1.5 (GND), U1.10 (GND), U1.12 (GND), WEMOS2.2
unnamed: DEL1.5 (CI), WEMOS1.4
unnamed: DEL1.4 (DI), WEMOS1.5
unnamed: DEL12.2 (CO), DEL13.5 (CI)
unnamed: DEL2.2 (CO), DEL3.5 (CI)
unnamed: DEL2.3 (DO), DEL3.4 (DI)
unnamed: DEL1.3 (DO), DEL2.4 (DI)
unnamed: DEL1.2 (CO), DEL2.5 (CI)
unnamed: DEL3.3 (DO), DEL4.4 (DI)
unnamed: DEL3.2 (CO), DEL4.5 (CI)
unnamed: DEL4.3 (DO), DEL5.4 (DI)
unnamed: DEL4.2 (CO), DEL5.5 (CI)
unnamed: DEL5.3 (DO), DEL6.4 (DI)
unnamed: DEL5.2 (CO), DEL6.5 (CI)
unnamed: DEL6.3 (DO), DEL7.4 (DI)
unnamed: DEL6.2 (CO), DEL7.5 (CI)
unnamed: DEL7.3 (DO), DEL8.4 (DI)
unnamed: DEL7.2 (CO), DEL8.5 (CI)
unnamed: DEL8.3 (DO), DEL9.4 (DI)
unnamed: DEL8.2 (CO), DEL9.5 (CI)
unnamed: DEL9.3 (DO), DEL10.4 (DI)
unnamed: DEL9.2 (CO), DEL10.5 (CI)
unnamed: DEL10.3 (DO), DEL11.4 (DI)
unnamed: DEL10.2 (CO), DEL11.5 (CI)
unnamed: DEL11.3 (DO), DEL12.4 (DI)
unnamed: DEL11.2 (CO), DEL12.5 (CI)
unnamed: DEL12.3 (DO), DEL13.4 (DI)
unnamed: DEL15.5 (CI), FFFFF.2 (CO)
unnamed: DEL15.4 (DI), FFFFF.3 (DO)
unnamed: DEL13.3 (DO), FFFFF.4 (DI)
unnamed: DEL13.2 (CO), FFFFF.5 (CI)
unnamed: DEL15.3 (DO), DEL16.4 (DI)
unnamed: DEL15.2 (CO), DEL16.5 (CI)
unnamed: DEL16.3 (DO), DEL17.4 (DI)
unnamed: DEL16.2 (CO), DEL17.5 (CI)
unnamed: DEL17.3 (DO), DEL18.4 (DI)
unnamed: DEL17.2 (CO), DEL18.5 (CI)
unnamed: DEL18.3 (DO), DEL19.4 (DI)
unnamed: DEL18.2 (CO), DEL19.5 (CI)
unnamed: DEL19.3 (DO), DEL20.4 (DI)
unnamed: DEL19.2 (CO), DEL20.5 (CI)
unnamed: DEL20.3 (DO), DEL21.4 (DI)
unnamed: DEL20.2 (CO), DEL21.5 (CI)
unnamed: DEL21.3 (DO), DEL22.4 (DI)
unnamed: DEL21.2 (CO), DEL22.5 (CI)
unnamed: DEL22.3 (DO), DEL23.4 (DI)
unnamed: DEL22.2 (CO), DEL23.5 (CI)
unnamed: DEL23.3 (DO), DEL24.4 (DI)
unnamed: DEL23.2 (CO), DEL24.5 (CI)
SCL: R2.1, U1.4 (SCL), WEMOS2.6
SDA: R1.1, U1.6 (SDA), WEMOS2.5

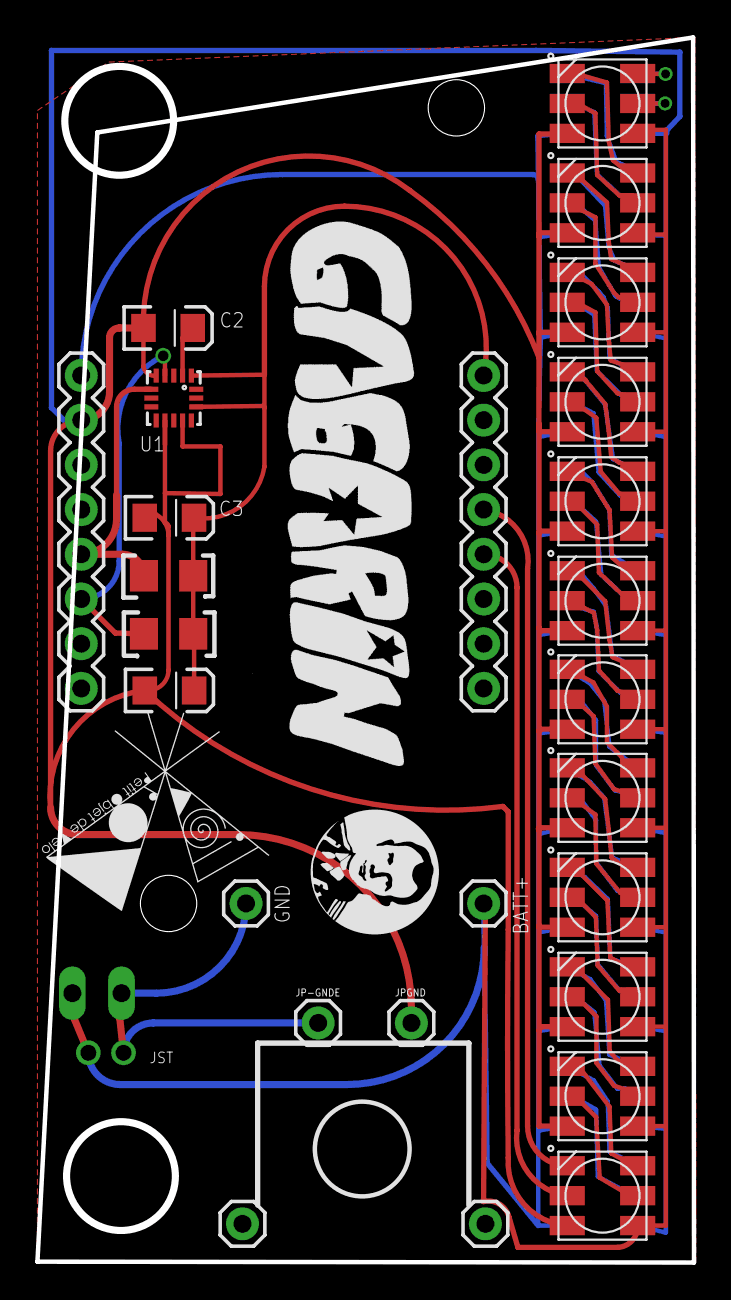
[picture p14: board AgitPOV_WiFi.brd from above]

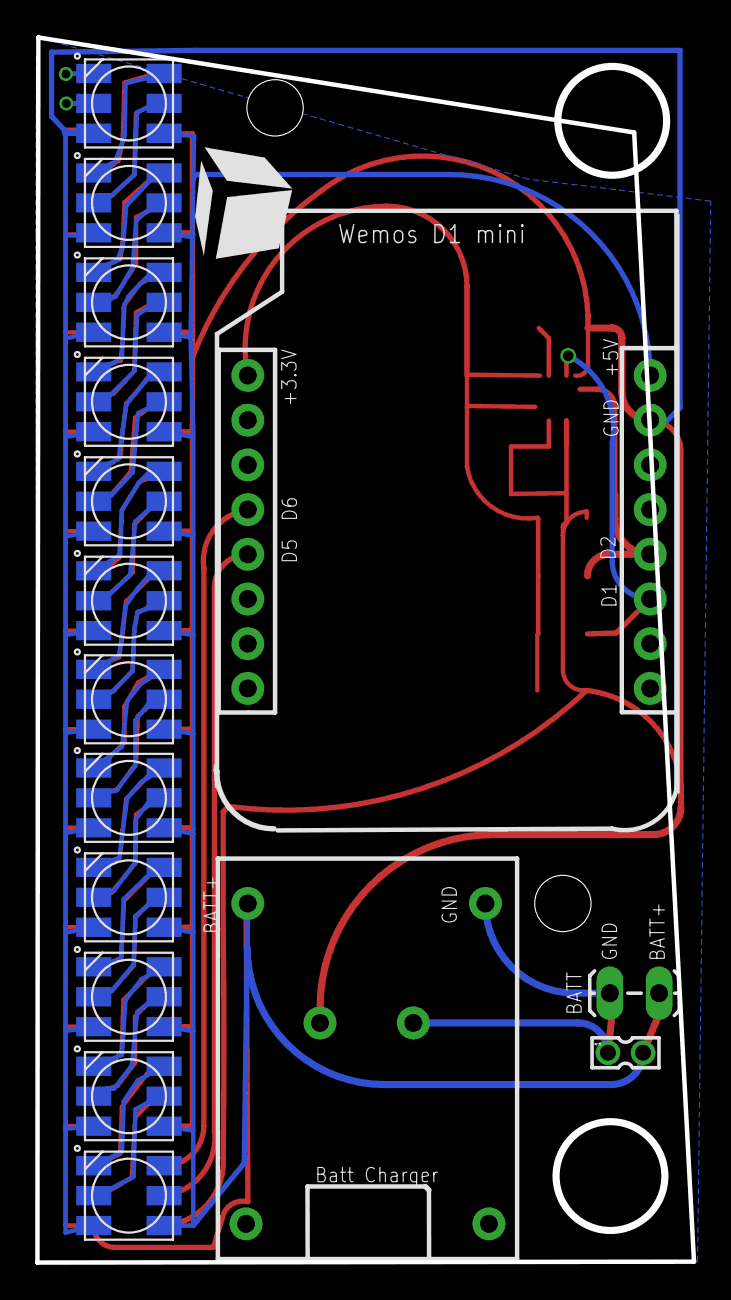
[picture p15: board AgitPOV_WiFi.brd from below]

Board: 2 copper layers, 37.3 x 69.6 mm, 40 parts (14 on the bottom side), 55 nets.
