AgitPOV/AgitPOV_WiFi/AgitPOVWIFI/AgitArray.ino

// STARTS WITH ASCII SPACE 32
// SUBSTRACT 32 FROM INPUT CHAR
#define MANQUANT {-1,-1,-1,-1,-1,-1,-1}
short charToPovArray[][7] = { /// merci // gracias // thank you Alex Keeling!!
//0+32=32
  {0, 0, 0, 0, 0, 0, 0}, //space U+0020 // 0
  {0, 0, 831, 895, 0, 0, 0}, //!
  {0, 0, 3, 0, 3, 0, 0}, //"
  {144, 1020, 144, 144, 144, 1020, 144}, //#
  {140, 274, 274, 1023, 274, 290, 196}, //$
  {256, 136, 64, 32, 16, 136, 4}, //%  //5
  {462, 1017, 561, 609, 497, 915, 528}, //&
  {0, 0, 0, 3, 0, 0, 0}, //'
  {0, 0, 252, 510, 513, 0, 0}, //(
  {0, 0, 513, 510, 252, 0, 0}, //)
  {17, 10, 4, 31, 4, 10, 17}, //*  //10
  {0, 32, 32, 248, 32, 32, 0}, //+ 0xf00, 0xf00, 0xf00, 0x000, 0x000, 0x000, 0x000 }
  {0, 0, 2816, 1792, 0, 0, 0}, //,
  {0, 32, 32, 32, 32, 32, 0}, //-
  {0, 0, 768, 768, 0, 0, 0}, //.
  {256, 128, 64, 32, 16, 8, 4}, ///   //15
//16+32=48
  {252, 510, 771, 771, 771, 510, 252}, //0 U+0030
  {512, 516, 518, 1023, 1023, 512, 512}, //1
  {774, 899, 705, 609, 561, 543, 526}, //2
  {385, 785, 561, 569, 621, 967, 387}, //3
  {30, 31, 16, 16, 1020, 1022, 16}, //4  //20
  {399, 783, 521, 521, 521, 1017, 497}, //5
  {510, 995, 529, 529, 529, 1011, 486}, //6
  {3, 897, 961, 97, 49, 31, 15}, //7
  {494, 1023, 529, 529, 529, 1023, 494}, //8
  {14, 31, 17, 17, 17, 1023, 1023}, //9  //25
  {0, 0, 780, 780, 0, 0, 0}, //:
  {0, 0, 2828, 1804, 0, 0, 0}, //;
  {32, 112, 216, 396, 774, 1539, 1025}, //<
  {0, 80, 80, 80, 80, 80, 0}, //=
  {1025, 1539, 774, 396, 216, 112, 32}, //>  //30
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
  {3168, 3174, 671, 287, 671, 3174, 3168}, //☠ U+2620 skull & cross bones
  {504, 644, 1106, 1090, 1106, 644, 504}, //☹ U+2639 frown
  {248, 324, 658, 642, 658, 324, 248}, //☺ U+263A smiley
  {248, 444, 878, 894, 878, 444, 248}, //☻ U+263B inverted smiley
  {28, 98, 390, 520, 390, 98, 28}, //♡ U+2661 heart           //175
  {28, 126, 510, 1016, 510, 126, 28}, //♥ U+2665 filled heart
  {362, 618, 522, 634, 522, 618, 362}, //〠 U+3020 Japanese postal mark
*/
};

void nouveauArray(String leMot) {
  Serial.print("nouveau mot  : ");
  Serial.println(leMot);

  // If we have a bad string, get out!
  if (leMot.length() <= 1 ) return;

  int n = leMot.length(); // byte count
  
  Serial.print("characterCount "); Serial.println(n);
  Serial.println("Starting to parse...");

  povArrayLength=0;
  int k=0; // valid character count
  for ( int i = 0; i < n ; i++ ) {
    byte b = byte(leMot.charAt(i));
    int c;
    if (b<0x80) {
      //Serial.printf("ascii byte %x\n",b);
      c=b; // ASCII
    } else if (b<0xC0) {
      Serial.printf("invalid byte %x\n",b);
      continue; // saute (invalide, pas de codepoint)
    } else if (b<0xE0) {
      //Serial.printf("utf-8 2 bytes %x %x\n",b,leMot.charAt(i+1));
      c=((b&0x1F)<<6) + byte(leMot.charAt(i+1) & 0x3F); //5+6=11 bits: inclut 15 fois plus de caractères que Latin-1 
      i++;
    } else {
      //Serial.printf("utf-8 more than 2 bytes %x %x ...\n",b,leMot.charAt(i+1));
      c=((b&0x0F)<<6) + byte(leMot.charAt(i+1) & 0x3F); //4+6+6=16 bits
      c=(c<<6) + byte(leMot.charAt(i+2) & 0x3F);
      if (b>=0xF0) {c=(c<<6) + byte(leMot.charAt(i+3) & 0x3F); i+=3;} //4+6+6+6=22 bits
      else i+=2;
    }
    // CONVERT TO CAPITALS
    if (c>=  97 && c <= 122) c -= 32; // ASCII
    if (c>= 224 && c <= 255) c -= 32; // Latin-1
    //if (c>=... && c<=...) c-=...; (il y a d'autres minuscules au delà de Latin-1)
    if (!dumpCharacterToPovArray(c)) {
      Serial.println("Input characters too long");
      break;
    } else k++;
  }
  Serial.print("validCharacterCount "); Serial.println(k);
  for (int y=0; y<12; y++) {
    for (int x=0; x<povArrayLength; x++) {
      Serial.print((povArray[x]>>y)&1 ? "#" : ".");
    }
    Serial.println("");
  }
}

bool dumpCharacterToPovArray( int character) { // retourne false s'il n'y a plus de place
  Serial.printf("Dumping 0x%x\n",character);
  // Convertir pour avoir l'index du tableau charToPovArray
  if (character<32) return true; // invalide : codes contrôle ASCII
  else if (character<127) character-=32; // si on a du ASCII, on commence au début de la table (0)
  else if (character<160) return true; // invalide : codes contrôle ISO_Latin
  else if (character <= 256) character-=65; // si on a du Latin-1, on commence à 95 pour le code 0xA0 (160=95+65)
  else return true; // autre Unicode au delà des codes Latin-1
  int ncols=0;
  for ( int j = 0 ; j < 7 ; j++ ) if (charToPovArray[character][j]!=-1) ncols++;
  if (povArrayLength+ncols+2>=POV_ARRAY_MAX_SIZE) return false;
  for ( int j = 0 ; j < 7 ; j++ ) {
    int col = charToPovArray[character][j];
    if (col!=-1) povArray[povArrayLength++] = col;
  }
  povArray[povArrayLength++] = 0x00; // 1er espace séparateur de caractères
  //povArray[povArrayLength++] = 0x00; // 2e espace...
  return true;
}
