AgitPOV/AgitPOV_WiFi/AgitPOVWIFI_GRANDE_ROUE/Leds.h

#include <FastLED.h>

#define DATAPIN    D6
#define CLOCKPIN   D5

class Leds {
    CRGB leds[24];

#define COLOR_COUNT 7

    //               rojo,    naranja, amarillo,   verde,    azul,     morado,   luz
    CRGB colors[COLOR_COUNT] = { 0xFF0000, 0xCC3300, 0xFFFF00, 0x00FF00, 0x0000FF, 0xFF00FF, 0xFFFFFF };



  public:

    void setup() {

      FastLED.addLeds<APA102, DATAPIN, CLOCKPIN, BGR>(leds, 24);


    }
    void blank() { // éteint toutes les lumières
      FastLED.clear();
      FastLED.show();
      
    }

    CRGB colorIdToColor(int colorId, int rainbowOffset) {
      if ( colorId == 7 ) return colors[(rainbowOffset / 2) % COLOR_COUNT];
      else return colors[colorId];
    }

    /*
        void blockingAnimation(int colorId, unsigned long duration) {
          unsigned long timeStarted = millis();
          float animationCounter = 0;
          while ( millis() - timeStarted < duration ) {
            byte grey = floor(sin(animationCounter*0.4-PI*0.5)*127+128);
            animationCounter++;
            for (int i = 0; i < 24; i++) {
              leds[i] = grey | ( grey << 8 ) | ( grey << 16 ) ;
            }
            FastLED.show();
            unsigned long yieldStarted = millis(); while ( millis() - yieldStarted <= 100 ) yield(); // 100 ms yield delay
          }
        }
    */

    void nonBlockingOsXAnimation() {

      //byte grey = floor(sin(millis() * 0.005 - PI * 0.5) * 127 + 128); // full intensity
      byte grey = floor(sin(millis() * 0.005 - PI * 0.5) * 64 + 64); // half intensity

      for (int i = 0; i < 24; i++) {
        leds[i] = grey | ( grey << 8 ) | ( grey << 16 ) ;
      }
      FastLED.show();

    }

    void blockingFadeOut(int colorId, unsigned long duration) {

      for (int i = 0; i < 24; i++) {
        leds[i] = colorIdToColor(colorId, i) ;
      }
      FastLED.show();

      unsigned long startTime = millis();
      unsigned long stepInterval = duration / 256;

      while ( millis() - startTime < duration ) {
        for (int i = 0; i < 24; i++) {
          leds[i]--;
        }

        FastLED.show();
        unsigned long yieldStarted = millis(); while ( millis() - yieldStarted <= stepInterval ) yield(); // stepInterval ms yield delay
      }
    }

    // Does an initilizing sequence timed with millis(). Returns immediatly.
    void nonBlockingRainbowAnimation() {


      for (int  i = 0; i <= 24 ; i++) { /// COLOR!!
        leds[i] = colorIdToColor(7, i + (millis() / 100));
      }

      FastLED.show();

    }

    /*
       // Does an initilizing sequence timed with millis(). Returns immediatly.
      void nonBlockingRainbowAnimation(int colorId) {

      int last = (millis() / 50) % 24;

      for (int  i = 0; i <= last ; i++) { /// COLOR!!
        leds[i] = colorIdToColor(colorId, i);
      }

      for (int  i = 23; i > last  ; i--) { /// BLACK!!
        leds[i] = CRGB::Black;
      }


      FastLED.show();

      }
    */

    void fill(int colorId) {

      for (int i = 0; i < 24; i++) {
        leds[i] = colorIdToColor(colorId, i);
      }
      FastLED.show();
    }

    void displayFrame(int sideAFrame, int sideBFrame, int colorId) {

      for (int i = 0; i < 12; i++) { // pour chaque DEL d'un côté
        if ( sideAFrame & 0x01 ) {
          leds[i] = colorIdToColor(colorId, i);
        } else {
          leds[i] = CRGB::Black;
        }
        sideAFrame = sideAFrame >> 1;
      }

      for (int i = 23; i > 11; i--) { // pour chaque DEL de l'autre côté dans le sens inverse vertical
        if ( sideBFrame & 0x01 ) {
          leds[i] = colorIdToColor(colorId, 23 - i);
        } else {
          leds[i] = CRGB::Black;
        }
        sideBFrame = sideBFrame >> 1;
      }

      FastLED.show();
    }

     void displayInversedFrame(int sideAFrame, int sideBFrame, int colorId) {

      for (int i = 11; i >= 0; i--) { // pour chaque DEL d'un côté
        if ( sideAFrame & 0x01 ) {
          leds[i] = colorIdToColor(colorId, i);
        } else {
          leds[i] = CRGB::Black;
        }
        sideAFrame = sideAFrame >> 1;
      }

      for (int i = 12; i < 24; i++) { // pour chaque DEL de l'autre côté dans le sens inverse vertical
        if ( sideBFrame & 0x01 ) {
          leds[i] = colorIdToColor(colorId, 23 - i);
        } else {
          leds[i] = CRGB::Black;
        }
        sideBFrame = sideBFrame >> 1;
      }

      FastLED.show();
    }


};



/*
  void dotPovInterval(){

  povInterval = _max((millis() - povTimeStamp),2)-1; // doit utiliser _max à cause d'un conflit de définition de fonction
  povTimeStamp = millis();
  povIntervalColumns = povInterval * povColumnWidth;
  if (povIntervalColumns > 10000){

    povIntervalColumns = 10000;
  }

  //Serial.print("IntervalColumns : ");
  //Serial.println(povIntervalColumns);

  }


  void dotDoIt() {
  // Serial.println("<<<<<<<<<<<<<<<<<<<<<<<<<<<<<");
  int arraySize = sizeof(povArray) / sizeof(int);
  for (int k = 0; k < arraySize; k++) { // la longueur du tableau qui contient le mot

    for (int i = 0; i <= 23; i++) { // pour chaque DEL // pour la premiére série :

      if ( i <= 11 ) {
        if ( bitRead(povArray[k], i % 12) ) {

          if (color == 7) {
            // Serial.print("on a vraiment du arcoiris Side A :");
            // Serial.println(i);

            switch (i) {
              case 0:
                leds[i] = 0xFF0000; // rojo
                break;
              case 1:
                leds[i] = 0xFF0000; // rojo
                break;
              case 2:
                leds[i] = 0xCC3300; // naranja
                break;
              case 3:
                leds[i] = 0xCC3300; // naranja
                break;
              case 4:
                leds[i] = 0xFFFF00; // amarillo
                break;
              case 5:
                leds[i] = 0xFFFF00; // amarillo
                break;
              case 6:
                leds[i] = 0x00FF00; // verde
                break;
              case 7:
                leds[i] = 0x00FF00; // verde
                break;
              case 8:
                leds[i] = 0x0000FF; // azul
                break;
              case 9:
                leds[i] = 0x0000FF; // azul
                break;
              case 10:
                leds[i] = 0xFF00FF; // morado
                break;
              case 11:
                leds[i] = 0xFF00FF; // morado
                break;
            } // fin du switch
          }

          else {
            leds[i] = color;
          }


        } else {
          leds[i] = CRGB::Black;
        }

      }

      else {

        if ( bitRead(povArray[arraySize - k], i % 12) ) { // bizarro world pour les DELs 23 à 12

          /////

          if (color == 7) {
            // Serial.print("on a vraiment du arcoiris B side :");
            // Serial.println(i);

            switch (i) {
              case 12:
                leds[35 - i] = 0xFF0000; // rojo
                break;
              case 13:
                leds[35 - i] = 0xFF0000; // rojo
                break;
              case 14:
                leds[35 - i] = 0xCC3300; // naranja
                break;
              case 15:
                leds[35 - i] = 0xCC3300; // naranja
                break;
              case 16:
                leds[35 - i] = 0xFFFF00; // amarillo
                break;
              case 17:
                leds[35 - i] = 0xFFFF00; // amarillo
                break;
              case 18:
                leds[35 - i] = 0x00FF00; // verde
                break;
              case 19:
                leds[35 - i] = 0x00FF00; // verde
                break;
              case 20:
                leds[35 - i] = 0x0000FF; // azul
                break;
              case 21:
                leds[35 - i] = 0x0000FF; // azul
                break;
              case 22:
                leds[35 - i] = 0xFF00FF; // morado
                break;
              case 23:
                leds[35 - i] = 0xFF00FF; // morado
                break;
            } // fin du switch
          }

          else {
            leds[35 - i] = color; // countdown 23 -> 12
          }


          /////

          // leds[35-i] = color; // countdown 23 -> 12

        } else {
          leds[35 - i] = CRGB::Black;
        }

      }


    }

    FastLED.show();
    delay(0);// Refresh strip //delayMicroseconds(1300); // Microseconds ne semble pas fonctionner avec le ESP8266
    delayMicroseconds(povIntervalColumns); // testing!!
    //updateAccelerometer();

  }

  dotBlank();
  }

*/
