AgitPOV/AgitPOV_WiFi/(commit log)

2017-01-10 Eagle files
    [AgitPOV_WiFi.brd, AgitPOV_WiFi.sch]
2017-01-10 Arduino file
    * ESP8266Wifi
    * WifiClient
    * Uses D3 for the interrupt
    * APA102C RGB LEDs
2017-01-10 First Bill of Materials
    [BOM.xlsx]
2017-01-16 Attempting to add a complete font w. special chars
    Ajouté la licence et les contributeurs au projet
    Merci à Alex Keeling, il reste des erreurs dans la détection de byte dans nouveauArray() mais c'est un bon début.
2017-01-16 Au bon endroit...
    Added Contributors
    Added the licence
    Attempt at a complete font, errors in nouveauArray()
    [AgitArray.ino, AgitPOVWIFI.ino]
2017-01-23 avec acceleromètre
    [BOM_AgitPOV_WiFi.xls]
2017-01-23 With an option (untested) of an accelerometer.
    [AgitPOV_WiFi.brd, AgitPOV_WiFi.sch, BOM_AgitPOV_WiFi.xls]
2017-01-25 Tout à sa place
    [AgitPOV_WiFi.brd, AgitPOV_WiFi.sch]
2017-01-26 added a capacitor for the accelerometer, DRChecked
    [AgitPOV_WiFi.brd, AgitPOV_WiFi.sch]
2017-01-26 proper ACCEL integration
    [AgitPOV_WiFi.brd, AgitPOV_WiFi.sch]
2017-02-20 Changed the interrupt pin from D3 to D7
    D3 (and D4) when pulled to GND will prevent the Wemos from booting :/.
    [AgitPOV_WiFi.brd, AgitPOV_WiFi.sch]
2017-02-20 Post-coffee commit
    [AgitPOV_WiFi.brd]
2017-02-21 Sin interrupt para el ACCEL! De regresar al sensor Hall en D4.
    [AgitPOV_WiFi.brd, AgitPOV_WiFi.sch]
2017-02-21 More integration, Hall sensor enabled on pin D4
2017-02-21 Swapped the MMA7660 for the MMA8452Q
    [AgitPOV_WiFi.brd, AgitPOV_WiFi.sch]
2017-02-21 Added pin headers for INT1 and INT2
    [AgitPOV_WiFi.brd, AgitPOV_WiFi.sch]
2017-02-23 Updated with the MMA8452 accelerometer
    [BOM_AgitPOV_WiFi.xls]
2017-03-14 Added UDP test and Accelerometer code
2017-03-19 essais avec l'accéléromètre
    UDP_Accelerometer.ino :
    Promising use of atan2 to get the angle from the accel.cx and
    access.cy values
    Values in X max out quickly (tilt over +8G)
    Y values are used instead
    Added a smoothing routine
    triggers a led sequence when
    everything seems slow but it’s promising (need to only make calls to
    accel.available() when the led routine is done
    UDP_Accelerometer.pd
    added arrays to the pd patch to visualize incoming data
2017-03-20 Fixed error with previous variables
    [UDP_Accelerometer.ino]
2017-03-20 tests avec PD
    la version _2 est instable pour le wifi?
2017-03-20 Fixing bad merge
    [AgitPOV_WiFi.brd, AgitPOV_WiFi.sch]
2017-03-21 Mean and lean board
    [AgitPOV_WiFi.brd, AgitPOV_WiFi.sch]
2017-03-25 Ajustement pour le tableau des caractères spéciaux
    Nouveau board
    [AgitPOV_WiFi.brd, AgitPOV_WiFi_01.brd, AgitPOV_WiFi_01.sch, BOM_AgitPOV_WiFi.xls]
2017-03-26 Retire tout ce qui a à voir avec le bouton et le capteur Hall
2017-03-26 Préparation pour inverser l'ordre des rangées de DELs
2017-03-28 New board version, FastLED display works.
    Board : removed button, Hall sensor, back to smd switch, cleaning
    around the accelerometer, removed int1 + int2, one less via! More space
    for the LEDs -> resized board.
    FastLED : correct GRB color space, bizarro world to display text on
    both sides.
    [AgitPOV_WiFi.brd, AgitPOV_WiFi.sch, AgitPOV_WiFi_01.brd, AgitPOV_WiFi_01.sch]
2017-04-04 Début de l'application
    Cordova avalanche
2017-04-04 Modélisation et code pour l'cccl
    [BOM_AgitPOV_WiFi.xls]
2017-04-16 Changements à la plaquette
    [BOM_AgitPOV_WiFi.xls, BOM_AgitPOV_WiFi_1.xls]
2017-04-16 un poco de color
2017-04-16 icônes de nouveau
2017-06-23 Cambios desde Manizales y Cartagena
    - luz de colores en la pagina html
    - individual AP desde el MAC address
    [AgitPOV_WiFi.GBL, AgitPOV_WiFi.GBO, AgitPOV_WiFi.GBP, AgitPOV_WiFi.GBS, AgitPOV_WiFi.GTL, AgitPOV_WiFi.GTO, AgitPOV_WiFi.GTP, AgitPOV_WiFi.GTS]
2017-06-24 Medellin Panama Newark
    intégration du code de Thomas
2017-07-07 intégration du code de Thomas
    [BOM_AgitPOV_WiFi.xls]
2017-07-08 Havre-aux-maisons 02
    - couleur persistante
    - persistent palabra
    - povIntervalColumns pour l’ajustement de la vitesse d’affichage
2017-07-11 hamac app
    - sauvegarde des icônes
    - préparation pour les apps
    [AC_1000_BOM_AgitPOV_WiFi.xls]
2017-07-19 arcoiris update (-) apps
    - retirer le code des apps
    - ajout du code de arcoris
    - formattage de la page html servie par le POV
    [AC_1000_BOM_AgitPOV_WiFi.xls, BOM_AgitPOV_WiFi_1.xls, roue_géante_de_vélos.xlsx]
2017-08-08 Fixed bugs and shit
    [AgitArray.ino, AgitFichier.ino, AgitPOVWIFI.ino, FrameAccelerator.h, Leds.h]
2017-08-11 Fixed bug about rotation of wheel and changed AP name
    [AgitPOVWIFI.ino, FrameAccelerator.h]
2017-08-15 Removed x from wheel
2017-08-15 un peu plus de style informatif
2017-08-15 Parts costs for 1000 units
    [AC_1000_BOM_AgitPOV_WiFi.xls]
2017-08-15 Ajout de la vitesse dans FrameAccelerator et modification de la détection de trigger
2017-08-15 essai pour restreindre les caractères
2017-08-15 essai de sync sans ajouter mes changements à
    AgitPOVWIFI.ino
    FrameAccelerator.h
2017-09-03 grande roue
    ajout du code pour la grande roue
    [AC_1000_BOM_AgitPOV_WiFi.xls]
2017-09-09 mathieu #3
    Les accents et bug frameCount
    [AC_1000_BOM_AgitPOV_WiFi.xls]
2019-07-22 Analysis and improvements to the lop
    Implementation of spiffs accelerometer data saving (careful, there is a
    200ms hit for every writing)
    Scripts for gnuplot to analyze the data
    Improvements to the low pass filter
    [AgitPOV_WiFi.brd]
2019-10-20 Dark design mode
    Meilleure constance de l’affichage
    Le ‘mode sombre’ ajouté, parfait pour les espaces sombres intérieurs
2022-07-09 Ukraina mode
    Un guia para otras colores
